Autonomous-Robotics-Carleton/2026/hardware/orin-carrier/altium/Imported jetson-orin-baseboard/jetson-orin-baseboard_3.png

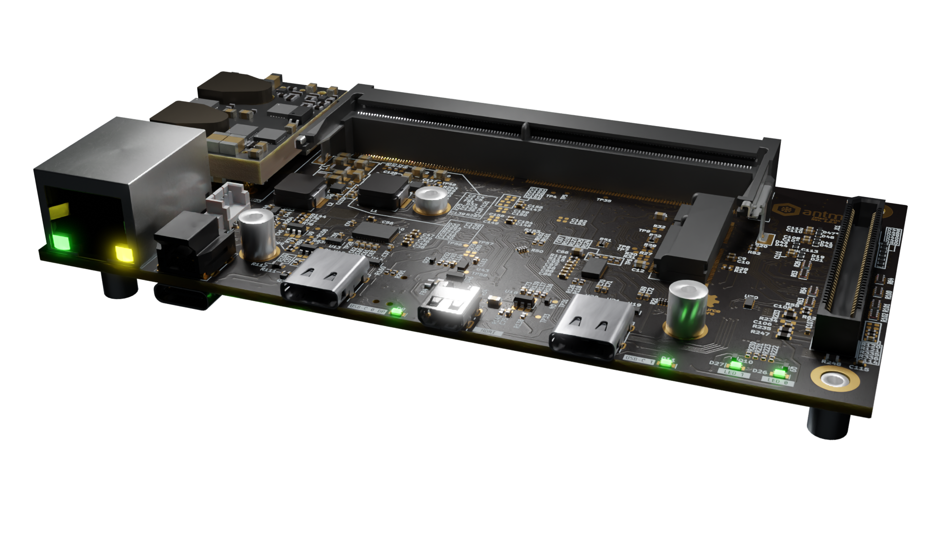
hardware/orin-carrier/altium/Imported jetson-orin-baseboard/jetson-orin-baseboard_3.png
