Autonomous-Robotics-Carleton/2026/hardware/README.md

# hardware

Board designs and mechanical exports. One folder per board, added when its design starts. [Motherboard](motherboard/README.md) contains the combined power/sync design plan; [Orin carrier](orin-carrier/README.md) contains the pinned Antmicro CAD sources and the Altium conversion status; `mechanical/` holds mechanical exports.

| Board | Handoff section |
| --- | --- |
| [Motherboard](motherboard/README.md) — one PCB for power (+ e-stop) and sync MCU | `systems/handoff/electrical.md` §1–2; ADR-0044 |
| Bus clamp assembly — PCB placement TBD | §1 |
| Motor controllers | §3: off-the-shelf A50S, so no board here (ADR-0034) |
| [Orin carrier](orin-carrier/README.md) (fork of Antmicro's baseboard) | §4 |
| [Remote sensor PCBs](sensor-boards/README.md) — custom angle, IMU and height/scale designs; layers TBC | §2 / §5; ADR-0052; no corner MCU |
| Harness | §5; [wiring/count schedule](../systems/bom/motherboard-wiring.md) |

Mechanical CAD lives in Fusion. `mechanical/` here holds STEP and drawing exports, committed per release.

## Rules

- Nothing is fabbed, machined or bought until it passes `systems/reviews/fab-gate.md`.
- Fab outputs (gerbers, BOM, pick-and-place) are committed only at a release tag, e.g. `power-board-r1`.
- Large binaries (STEP, PDFs, zips: zip your gerbers) go through git LFS.
