Autonomous-Robotics-Carleton/2026/hardware/orin-carrier/altium/Imported jetson-orin-baseboard/peripherals_2.png

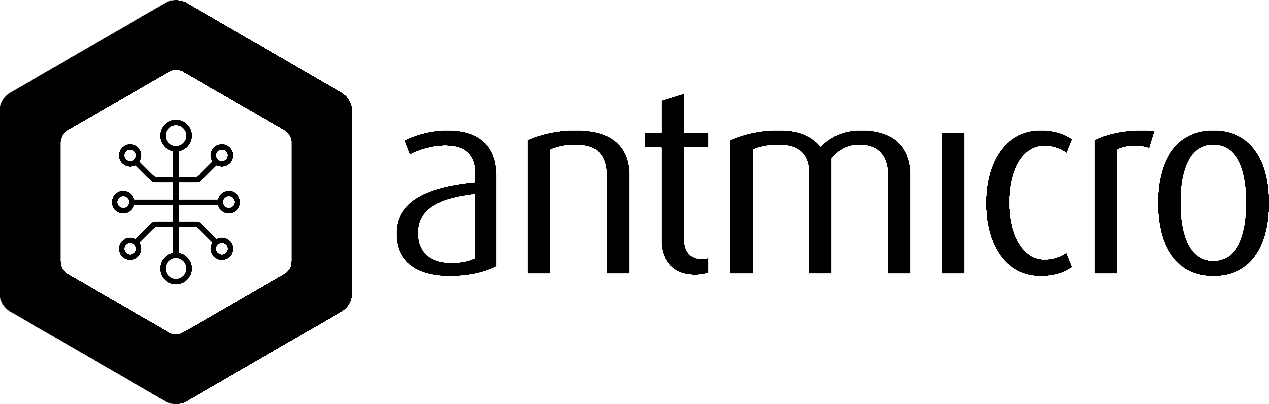
hardware/orin-carrier/altium/Imported jetson-orin-baseboard/peripherals_2.png
