Autonomous-Robotics-Carleton/2026/(list of files, drawings)

Other design files:
hardware/orin-carrier/altium/Imported jetson-orin-baseboard/csi.SchDoc
hardware/orin-carrier/altium/Imported jetson-orin-baseboard/ethernet.SchDoc
hardware/orin-carrier/altium/Imported jetson-orin-baseboard/jetson-orin-baseboard.PcbDoc
hardware/orin-carrier/altium/Imported jetson-orin-baseboard/m-2.SchDoc
hardware/orin-carrier/altium/Imported jetson-orin-baseboard/som.SchDoc
hardware/orin-carrier/altium/Imported jetson-orin-baseboard/usb.SchDoc
