Autonomous-Robotics-Carleton/2026/(commit log)

2026-02-19 feat(web): add placeholder car wireframe
2026-10-13 feat(sim + ground station): foundation of ground station and sim set up
2026-10-13 feat(ground-station): redesigned ui and added popups for more data
2026-10-16 docs(systems): align EE decisions, wiring and funding budget
2026-10-16 docs(systems): refine PCB funding estimate with JLC evidence
2026-10-16 docs(systems): fund one car with in-house sensor boards
2026-10-16 docs(systems): update one-car electrical BOM and funding
    Record the B0223 camera pair and 500 GB storage choice with the remaining
    timing, bandwidth, ground-speed and logging qualification work.
    Add new-unit CAD pricing, purchase sources and per-board component
    breakdowns, including the complete imported carrier reference inventory.
    Exclude purchased motor-controller spares from the one-car scope.
2026-10-16 docs(systems): drop the withdrawn A50S CAN-FD detour
    ADR-0041 and ADR-0043 proposed drive CAN-FD and A50S-local FD
    adapters, and ADR-0049 withdrew them and returned to UART, which is
    what ADR-0034 already decided on main. None of the three reached
    main, so they go, along with the drive-FD ICD, the FD feasibility
    review and the deprecated VESC parts and shortlist pages.
    ADR-0049's useful details move into ICD-controller-telemetry (harness
    conductors, PB10/PB11) and references point at ADR-0034. ADR-0011,
    ADR-0013 and ADR-0036 return to main, so the steering bus keeps its
    lower-rate fallback. SYS-24 and SYS-25 return to main: the transport
    belongs in the ADR and ICD, not the requirement. The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
2026-10-16 docs(systems): keep e-stop braking as on main
    ADR-0047 required a physical stop even with every controller's
    firmware halted, which needs an independent brake (E-34). The car
    brakes with its motors: the e-stop is the controlled braked stop and
    hardware torque cut of ADR-0012 as amended by ADR-0034, and a hung
    controller coasting until the cut stays an accepted, open risk
    (RSK-11). ADR-0047 and E-34 go; SYS-05, RSK-11, ADR-0012 and the
    SYS-05 verification row return to main.
    The cost pages still mention E-34; they are reworked per build later
    in this series.
2026-10-16 docs(systems): keep the event cameras and 4 TB SSD for v1.1
    ADR-0053 swapped both GenX320s for B0223 frame cameras and the 4 TB
    SSD for 500 GB. v1.1 is main's design, so it keeps the two event
    cameras and the 4 TB drive; v1.0's B0223 and 1 TB drive are recorded
    with the builds later in this series. ADR-0053 goes; ADR-0014,
    ADR-0021, ADR-0025, SYS-10, LIM-03, LIM-05, RSK-01, RSK-07, RSK-13
    and the camera rows return to main, and LIM-09 is dropped.
    ICD-carrier-sync now names the GenX320 Trigger In pulses instead of
    B0223 frame triggers.
2026-10-16 docs(systems): keep the two spare A50S controllers
    ADR-0054 dropped the two spares. They stay, as on main: a failed
    controller would otherwise stop the car until a new UK order
    arrives, and the software plan uses a spare as the VESC development
    board (software/architecture.md, setup-plan.md). ADR-0054 goes.
2026-10-16 docs(systems): fold the sensor-board ADRs into one, five ToFs
    ADR-0050 and ADR-0051 were superseded by ADR-0052 within this branch,
    so the three become one ADR-0052: every vehicle-state sensor sits on
    our own small board with no MCU, assembled in house, with ISM330DHCXTR
    at both IMU sites and one board design per family.
    The sensor counts stay as on main, so the fifth ToF beside the
    ground-speed camera returns for its scale (ADR-0007, now Accepted
    again): 17 boards, 17 runs and 111 conductors. E-20 is recorded as
    industrial grade (3 °/h typical gyro bias instability, ST DS13012
    Rev 7), with a better CG IMU as a v1.1 option if testing shows it
    limits slip estimation.
2026-10-16 docs(systems): keep the Castle 1010 and its thermistor fallback
    ADR-0046 required motors with a documented built-in temperature
    sensor and dropped the E-28 thermistors, which demoted the Castle
    1010 and left the drive motor TBD. No Ø28 mm, 4S-capable sensored
    motor with a documented sensor turned up, and the fallback costs
    about $10, so main's plan stays: use the Castle's own sensor if it
    has one, otherwise glue E-28 to the can. Both go to the A50S's motor
    temp input, so protection and logging work either way.
    Additions: ask Castle for the sensor-plug pinout and confirm four in
    stock before ordering (E-51); the corner's inline plug keeps a spare
    contact for an E-28 lead; the VESC configura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
2026-10-16 docs(systems): leave ICD owners TBD, as on main
    The branch named one person as owner on both sides of every ICD and
    added a sign-off matrix recording it. An ICD needs a different owner
    on each side to approve changes, and assigning them is the team's
    call, so the owners go back to TBD and signoff.md goes. The new ICDs
    (power-rails, power-sync-stack, carrier-sync) stay as drafts with
    owners TBD. Test, review and board owners are unchanged.
2026-10-16 docs(systems): name the deciders on the ADRs that stay
    Several ADRs recorded the EE's instructions as accepted decisions,
    with "the owner" meaning the EE. ADR-0044 (one combined power/sync
    motherboard) is accepted by both of us; ADR-0042, ADR-0045 and
    ADR-0048 stay proposals with the EE as proposer. Text that credited
    "the owner" with a choice now says who made it, or drops the claim.
    The SCH16T row in the parts list becomes the v1.1 CG IMU candidate.
2026-10-16 docs(systems): add the v1.0 dev kit to the board size estimates
    v1.0 runs on the Orin Nano developer kit's own carrier and module, so
    ADR-0045 now lists its envelope next to the Antmicro assembly and asks
    for a compute bay that takes both, with airflow for the v1.1 NX.
2026-10-16 docs(systems): renumber the new ADRs to follow ADR-0040
    With the withdrawn and reverted ADRs gone, the ones that stay become
    ADR-0041 to ADR-0045 (grounding, combined motherboard, board sizes,
    EE sizing review, sensor boards). None of them is on main yet, so no
    merged ID changes.
2026-10-16 docs(systems): split the v1 car into builds v1.0 and v1.1
    ADR-0046: v1.1 is the full design in systems/. v1.0 is built first
    on the Orin Nano developer kit and UST-20LX from the team's existing
    car, with the stereo pair and a downward B0223 as its only cameras, a
    1 TB SSD and LED-only ground lighting. Everything else is the same in
    both builds, and v1.0 is built for v1.1: the motherboard is the v1.1
    board, and the compute bay, camera mounts and NX cooler room are
    there from the start.
    builds.md tracks what each build contains and its order; the BOM rows
    that differ carry a v1.0 note. LIM-09 to LIM-11 record v1.0's limits,
    RSK-23 its non-locking dev kit connectors, and RSK-01 now applies
    fro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
2026-10-16 docs(systems): price each build
    The cost pages priced one car with B0223 cameras, a 500 GB SSD, no
    controller spares, four ToFs and the custom carrier. They now price
    v1.0 and v1.1 (ADR-0046) from the same supplier checks, FX and
    method: 13% HST, 30% contingency on the PCBs only.
    - v1.0: CAD $6,723.58, a $6,800 request; PCBs $1,950.29 with
    contingency. Compute and LiDAR are on loan.
    - v1.1: CAD $7,582.27, a $7,600 request: NX, carrier, NX cooler,
    UST-10LX, quad kit, two GenX320s (allowance until quoted), 4 TB.
    cost.csv and jlc-pcba-cost.csv gain a build column (both, v1.0,
    v1.1). The camera logging check now covers v1.0's three cameras: about
    296 MB/s, so the 1 TB drive needs at least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
2026-10-16 feat(hardware): store the Altium carrier conversion in Git LFS
    The 43 Altium binaries (PcbDoc, SchDoc, SchLib, templates and images,
    about 33 MB) were committed as plain Git blobs because the fork could
    not upload LFS objects. They now go through LFS like the repo's other
    CAD binaries; the .PrjPcb project file and the pinned KiCad source,
    which is self-contained text, stay in plain Git.
